ggajoch/SolderingStation/README.md

# Soldering station for Weller RT tips.
