ggajoch/SolderingStation/(list of files, cad)

Other CAD files:
3D/Hand.ipt
3D/case_bottom.ipt
3D/case_top.ipt
3D/stand.ipt
