ggajoch/SolderingStation/Hardware/Main/Show.PDF

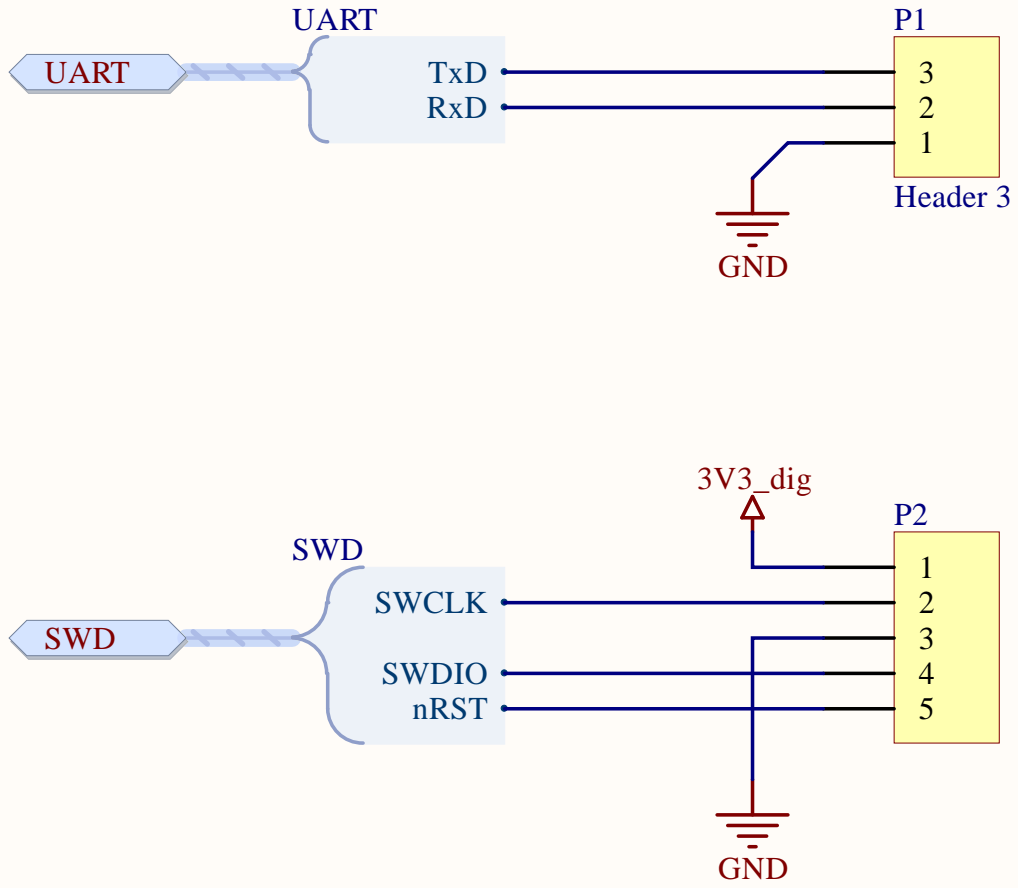
[picture p1: page 1]

Debug connectors Title | * Grzegorz Gajoch grzegorz@gajoch.pl

Size: A4 | Number: | Revision:
Date: 08-Oct-16 Time: 05:38:01 AM | | Sheet * of

E:\repos\WellerSolderingStation\Hardware\Main\DBG.SchDoc

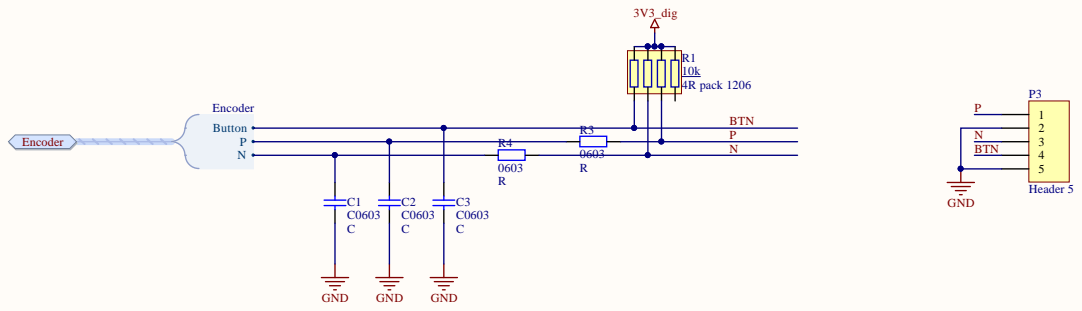
[picture p2: page 2]

Enco der connecto r T i t l e | *G rzeg o rz G aj och g rzeg o rz@g aj och.p l

Size: A | N umber: | Rev i s i o n :

8-Oct-1 T ime: : : A M | | Sheet o f

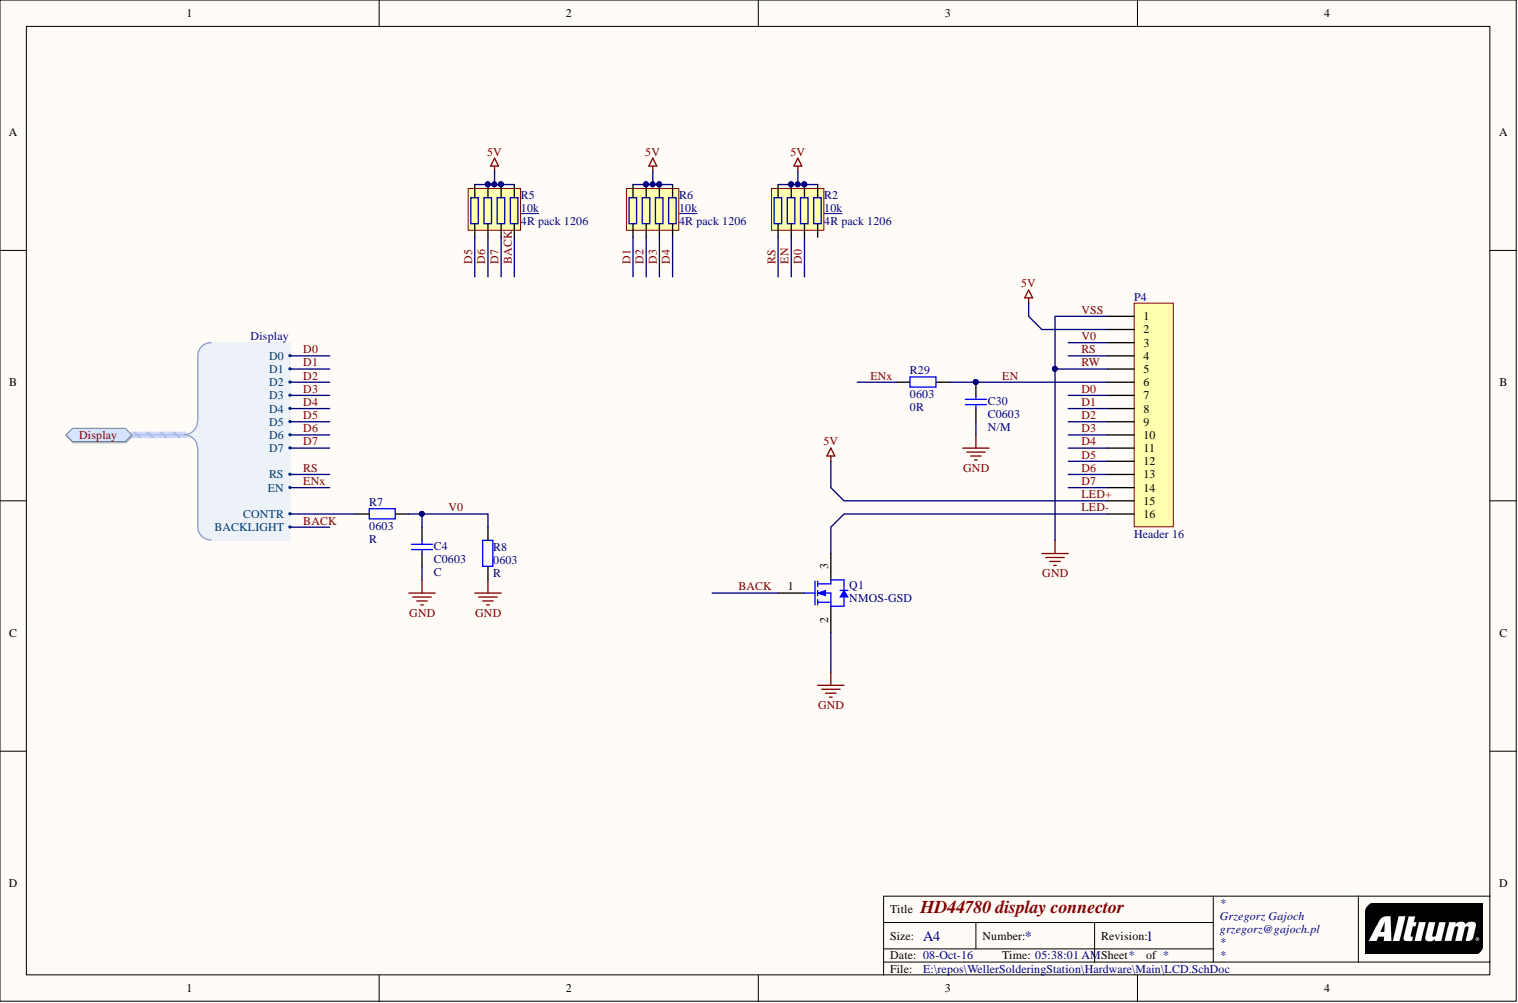
[picture p3: page 3]

HD 44 78 0 display connecto r T i t l e | *G rzeg o rz G aj och g rzeg o rz@g aj och.p l

Size: A | N umber: | Rev i s i o n :

8-Oct-1 T ime: : : A M | | Sheet o f

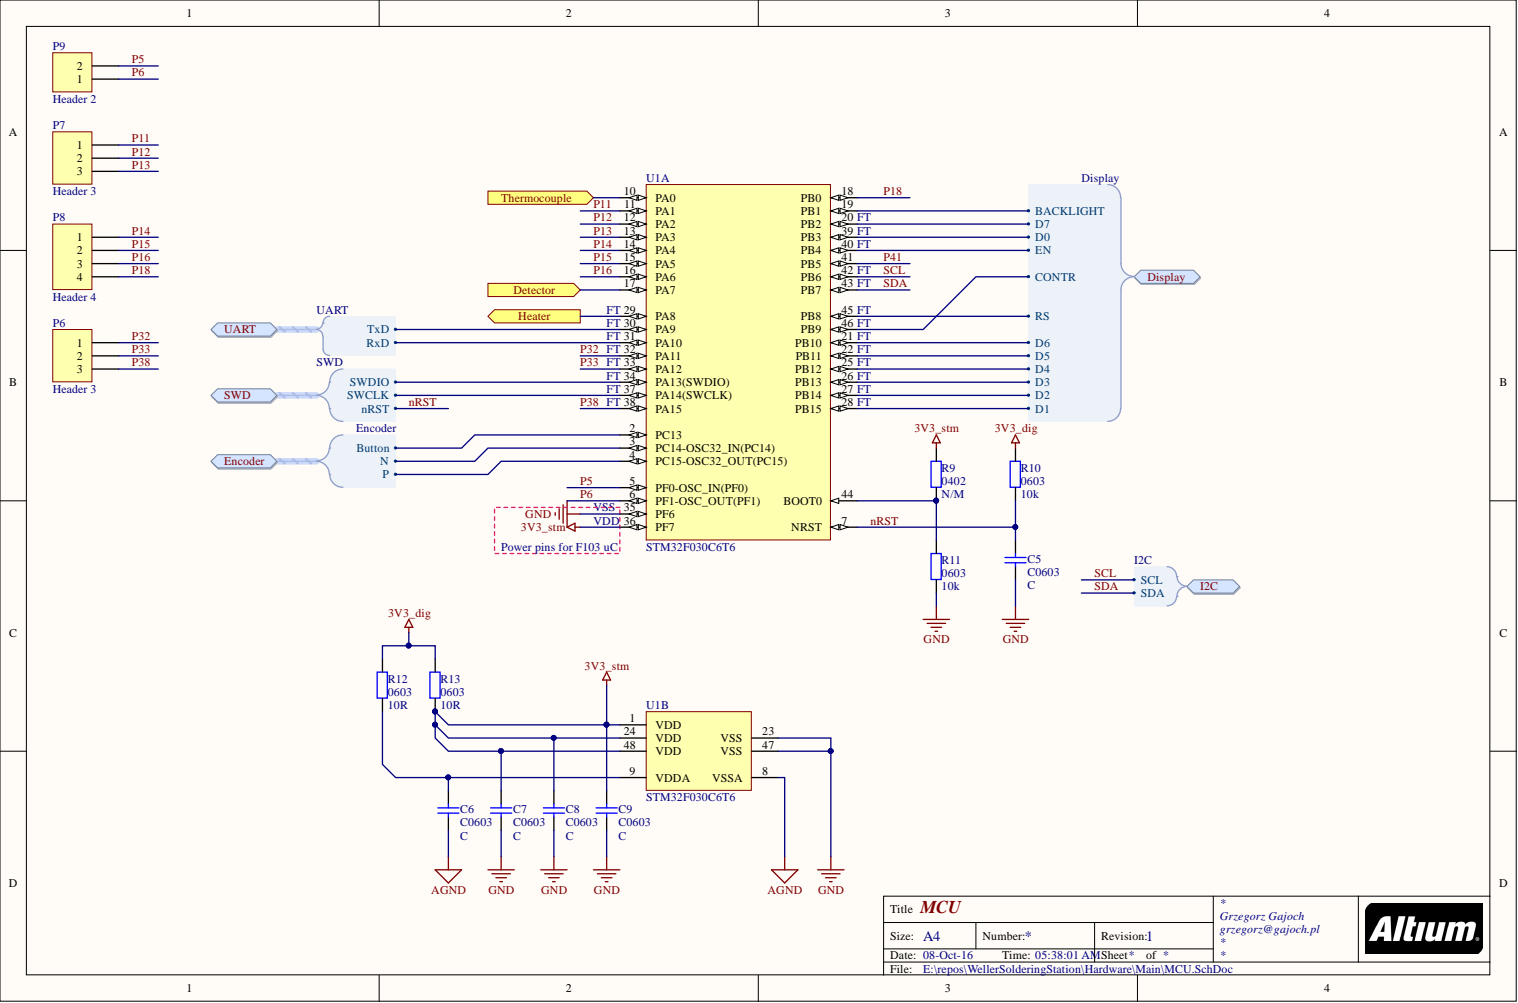
[picture p4: page 4]

PF6 35 | nRST
PF7 36

Power pins for F103 uC

MCU Title | * Grzegorz Gajoch grzegorz@gajoch.pl *

Size: A4 | Number: | Revision:
08-Oct-16 Time: 05:38:01 AM | | Sheet of *

E:\repos\WellerSolderingStation\Hardware\Main\MCU.SchDoc

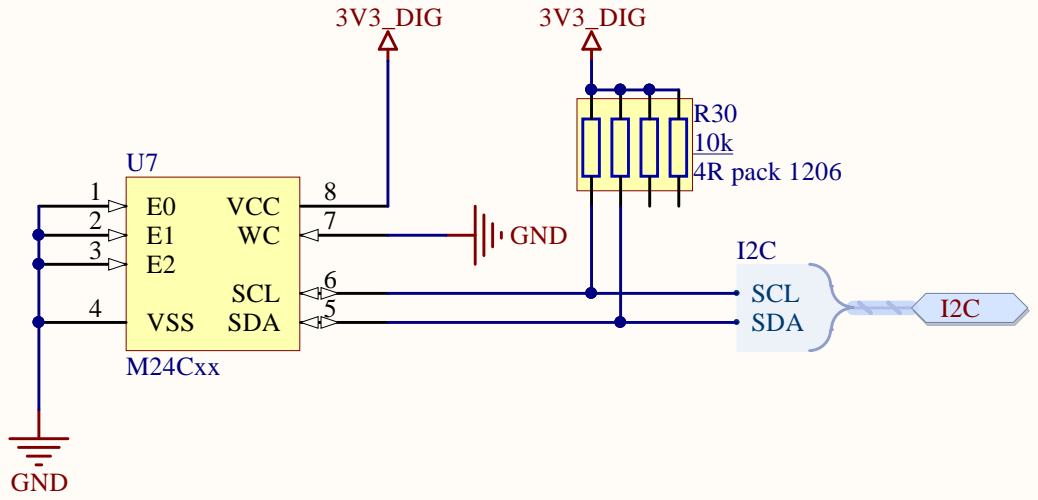
[picture p5: page 5]

I2C memory T i t l e | *G rzeg o rz G aj och g rzeg o rz@g aj och.p l

Size: A | N umber: | Rev i s i o n :

8-Oct-1 T ime: : : A M | | Sheet o f

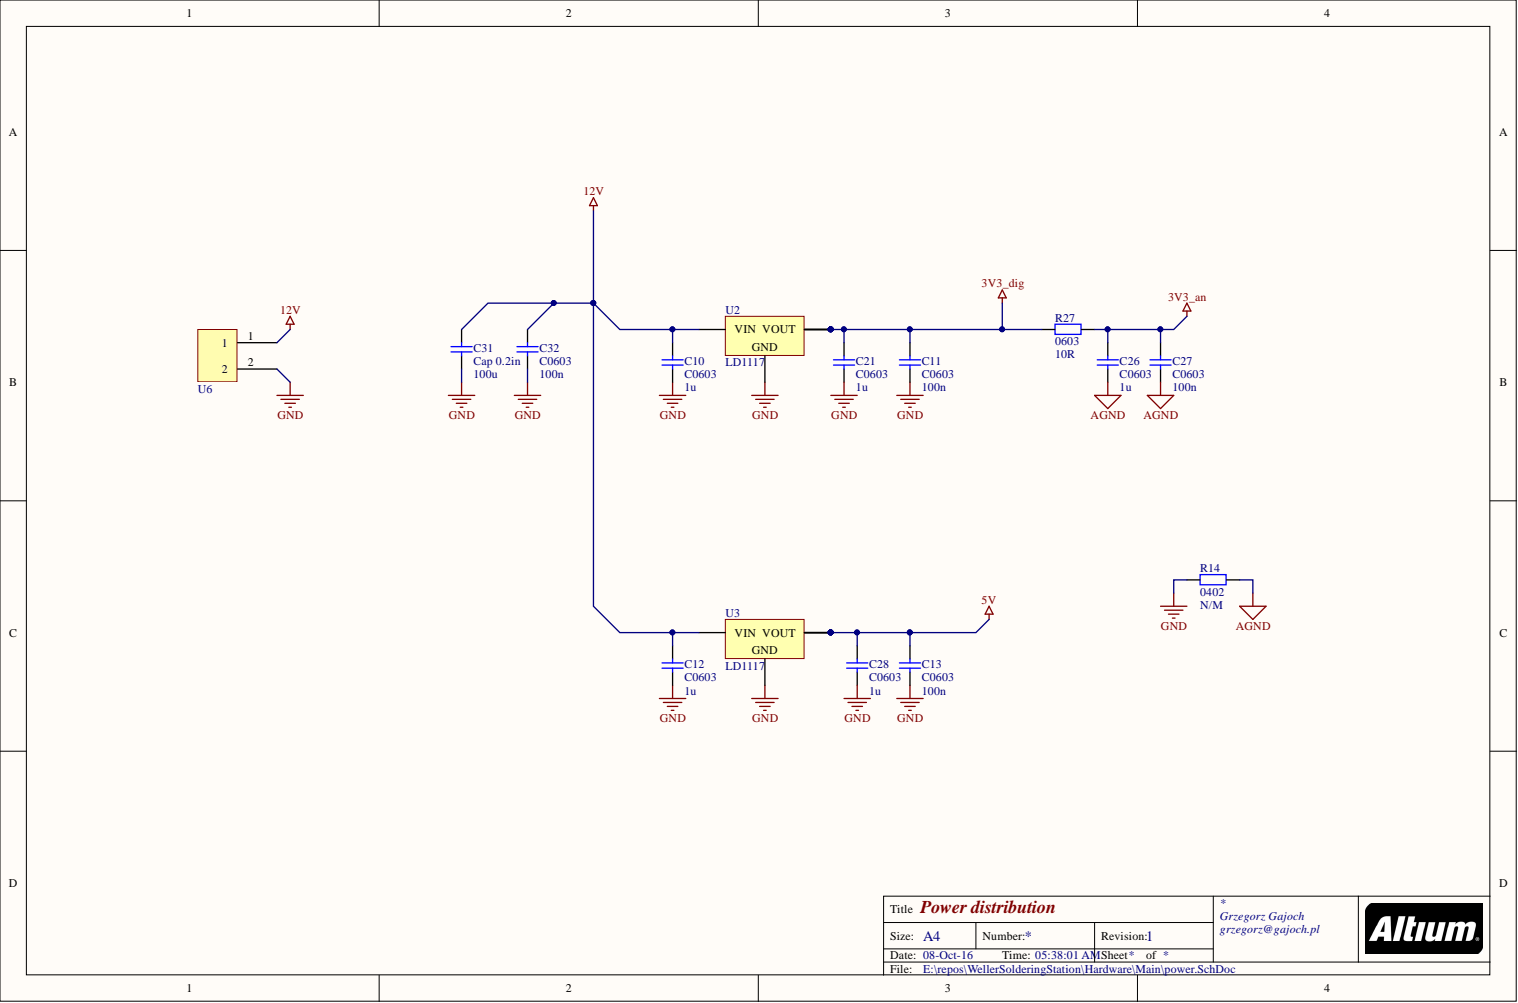
[picture p6: page 6]

Power distribution Title | * Grzegorz Gajoch grzegorz@gajoch.pl

Size: A4 | Number: | Revision:
08-Oct-16 Time: 05:38:01 AM | | Sheet of

E:\repos\WellerSolderingStation\Hardware\Main\power.SchDoc

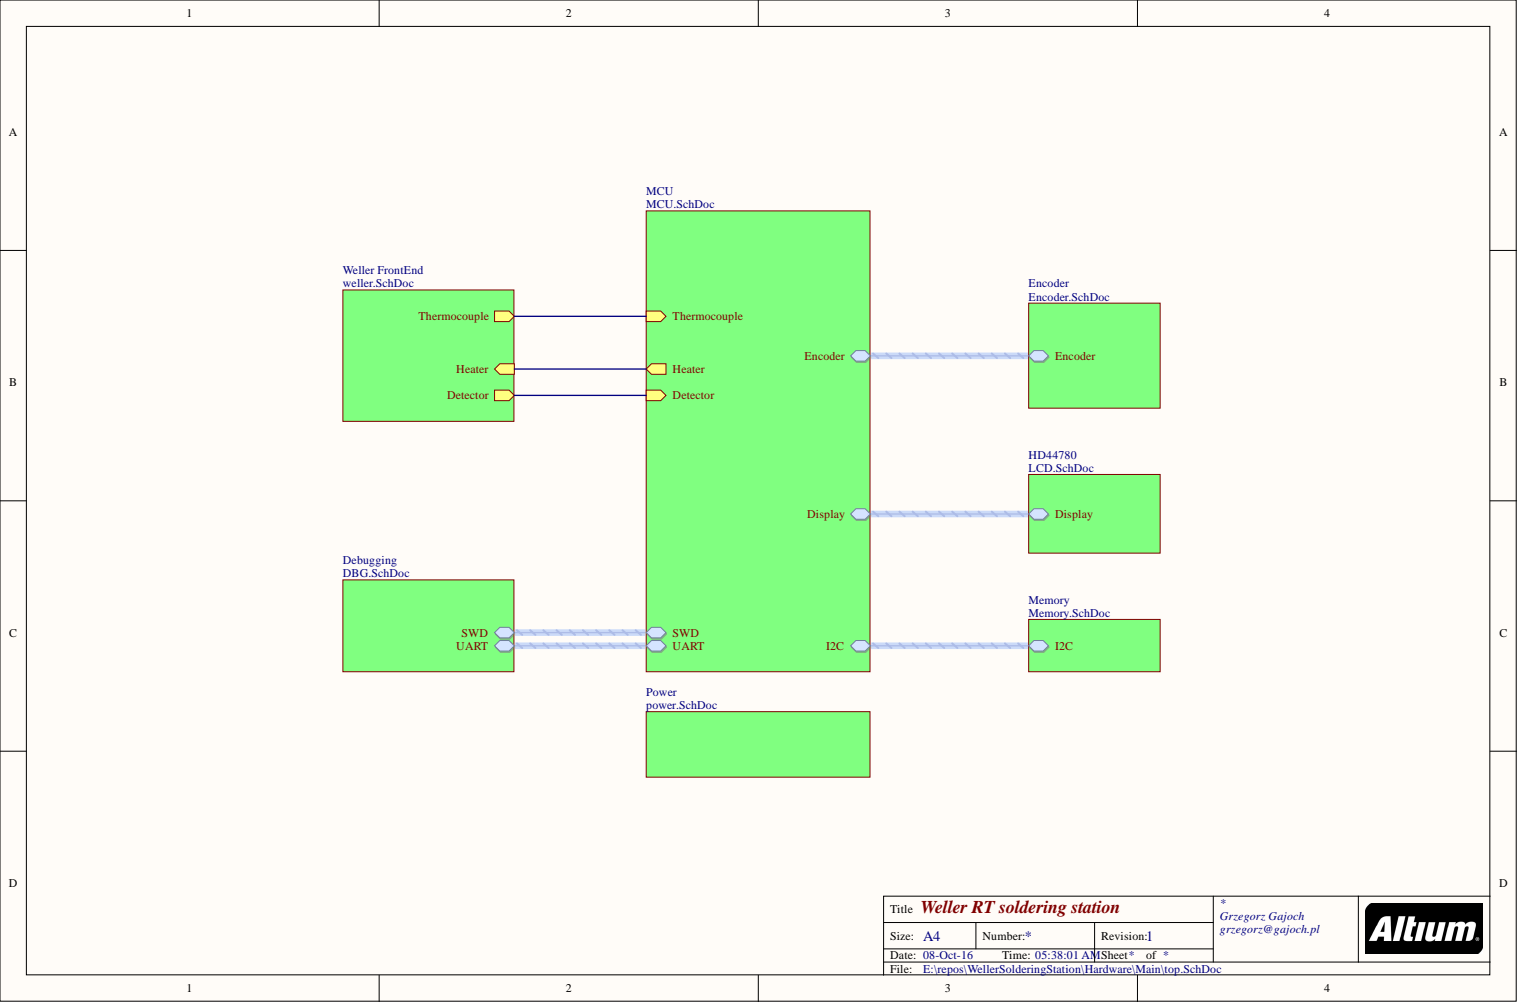
[picture p7: page 7]

Weller RT soldering station Title | * Grzegorz Gajoch grzegorz@gajoch.pl

Size: A4 | Number: | Revision:
08-Oct-16 Time: 05:38:01 AM | | Sheet of

E:\repos\WellerSolderingStation\Hardware\Main\top.SchDoc

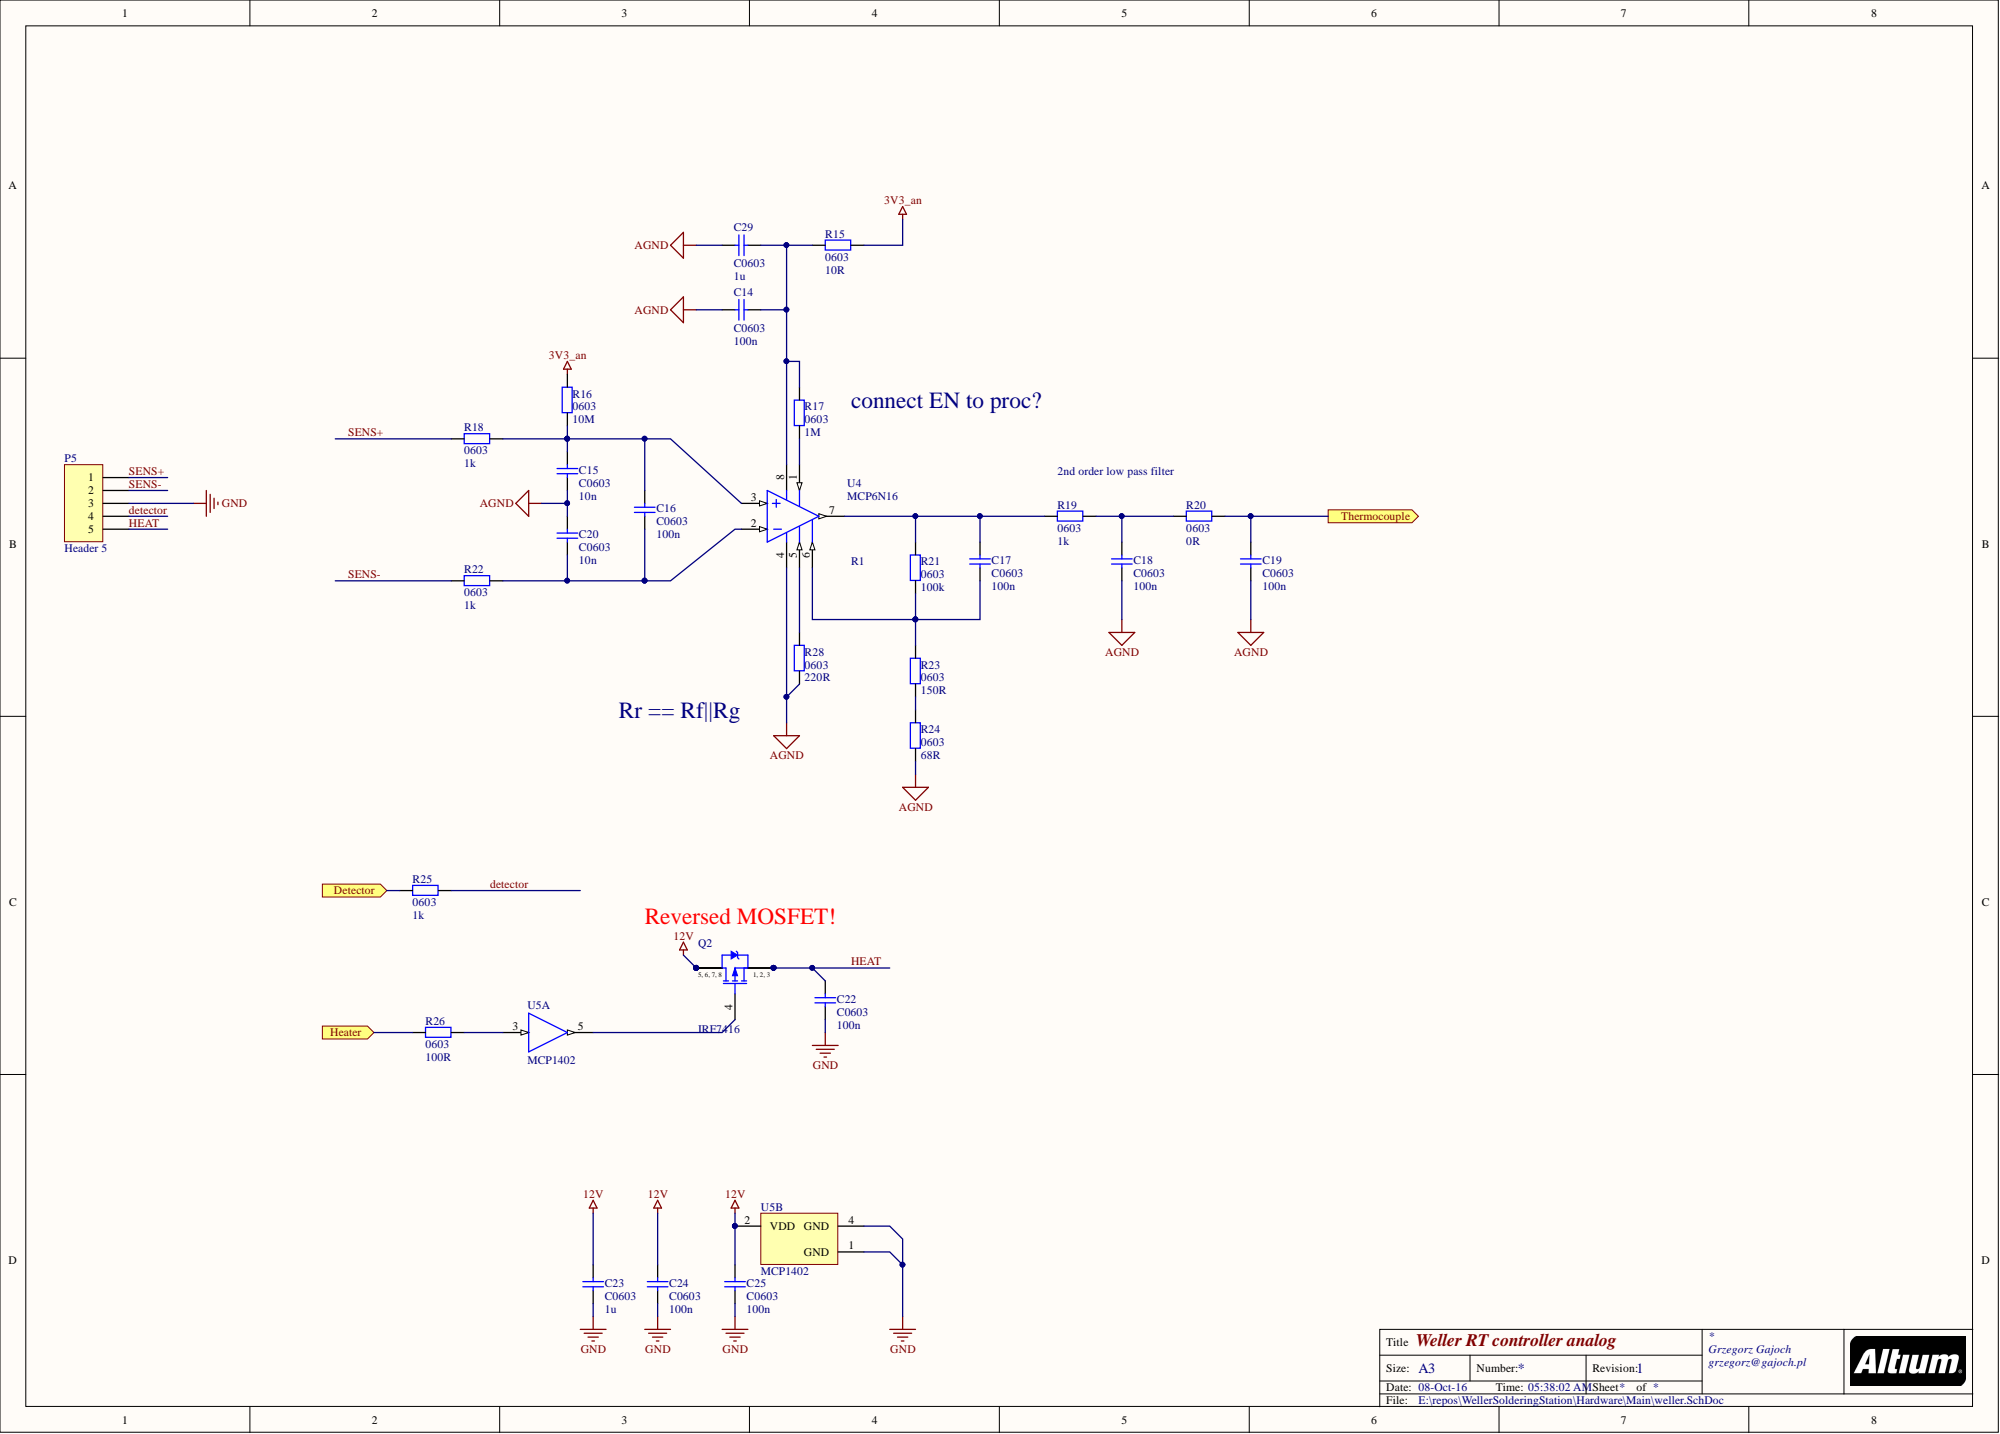
[picture p8: page 8]

connect EN to proc?

2nd order low pass filter

Weller RT controller analog Title | Grzegorz Gajoch grzegorz@gajoch.pl

Size: A3 | Number: | Revision:
08-Oct-16 Time: 05:38:02 AM | | Sheet of

E:\repos\WellerSolderingStation\Hardware\Main\weller.SchDoc

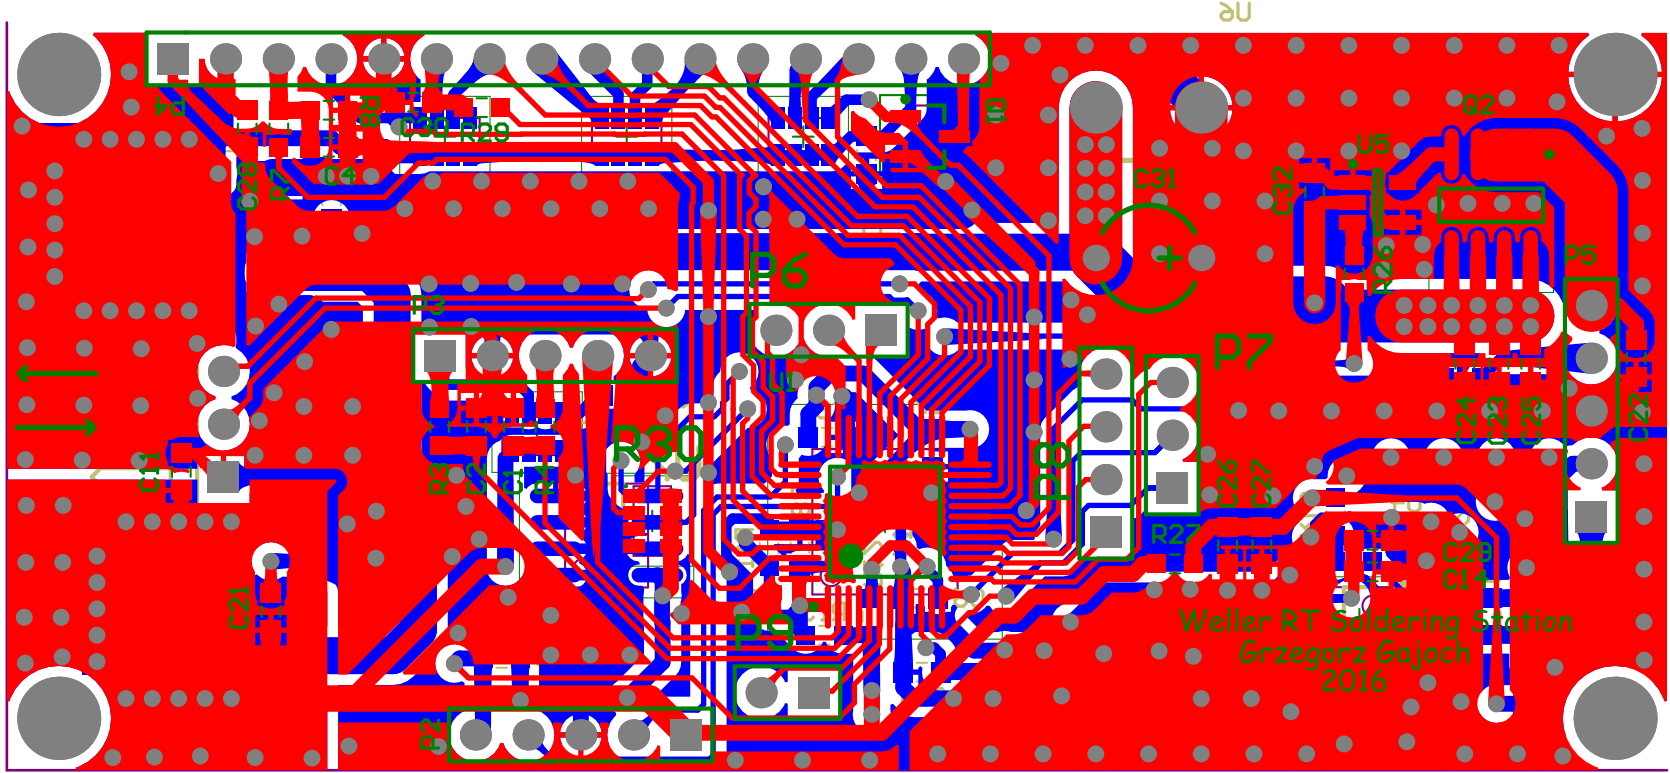
[picture p9: page 9]

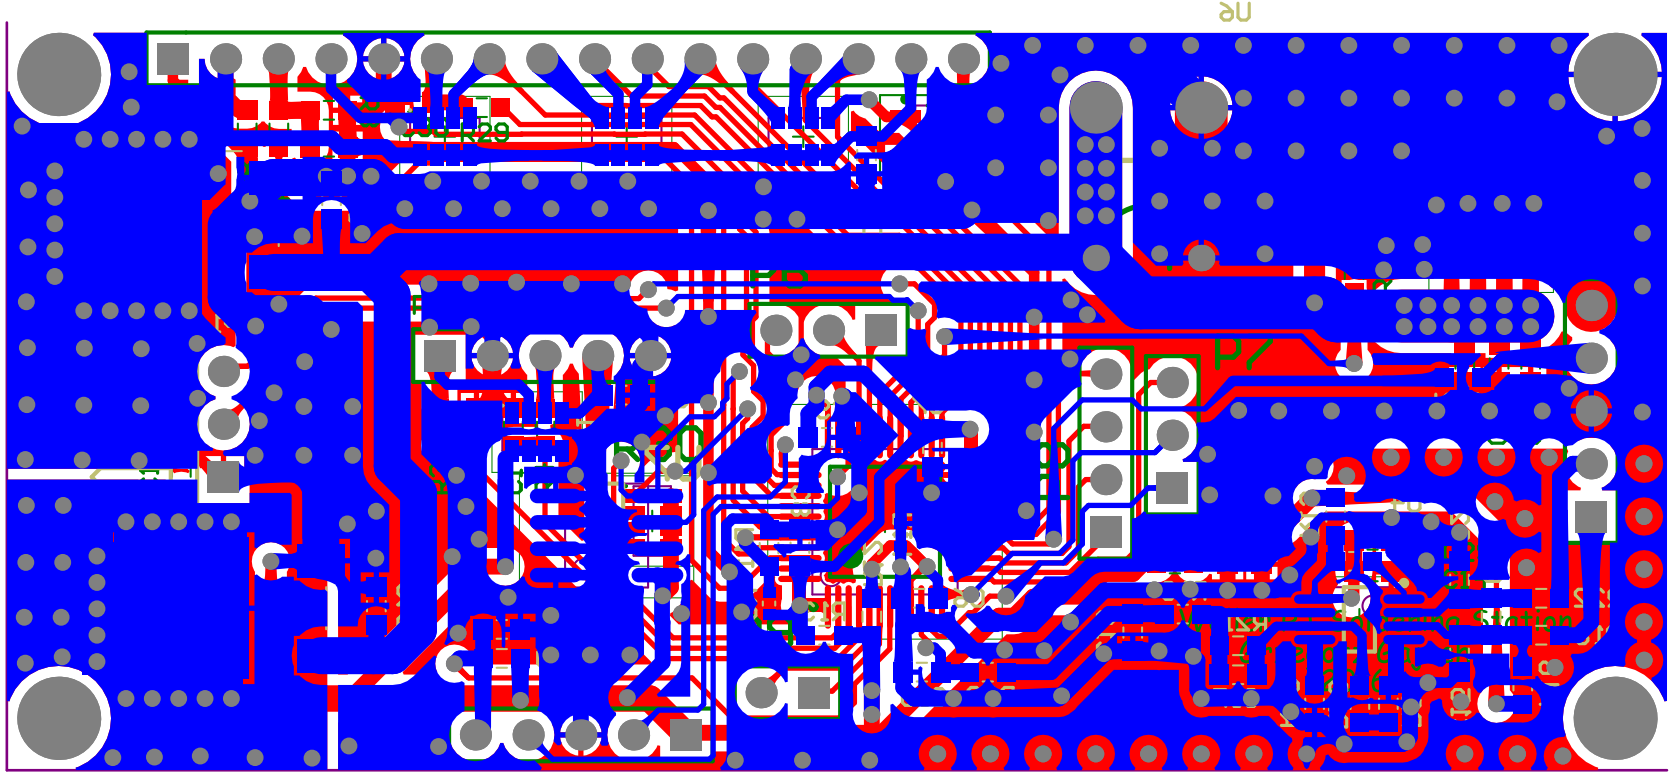
[picture p10: page 10]

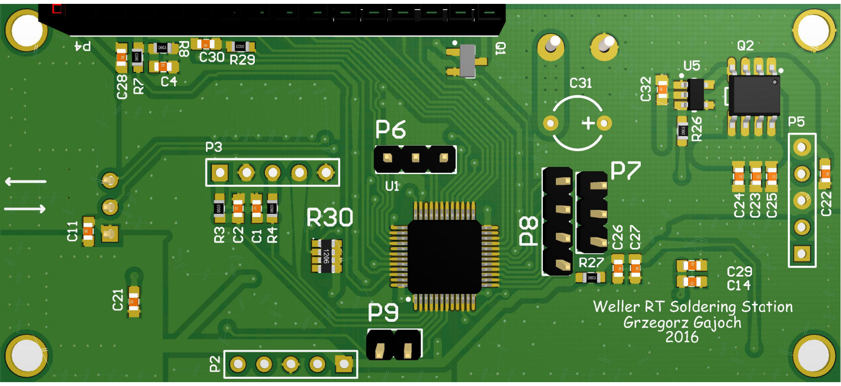
[picture p11: page 11]

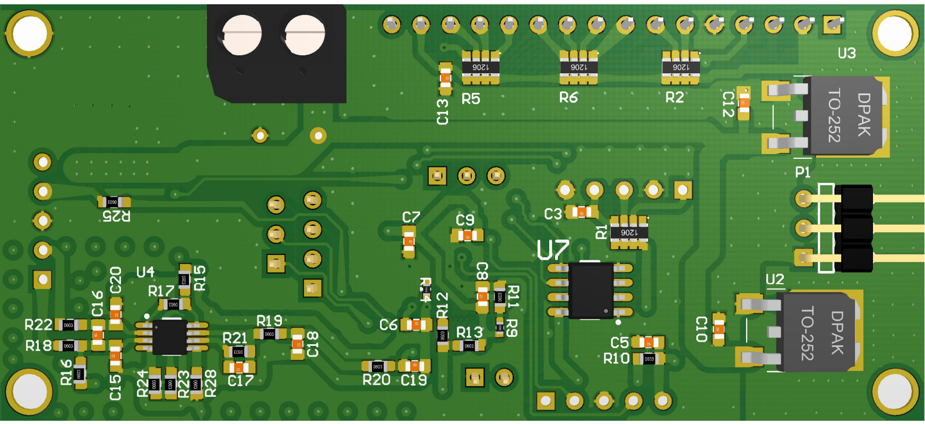
[picture p12: page 12]

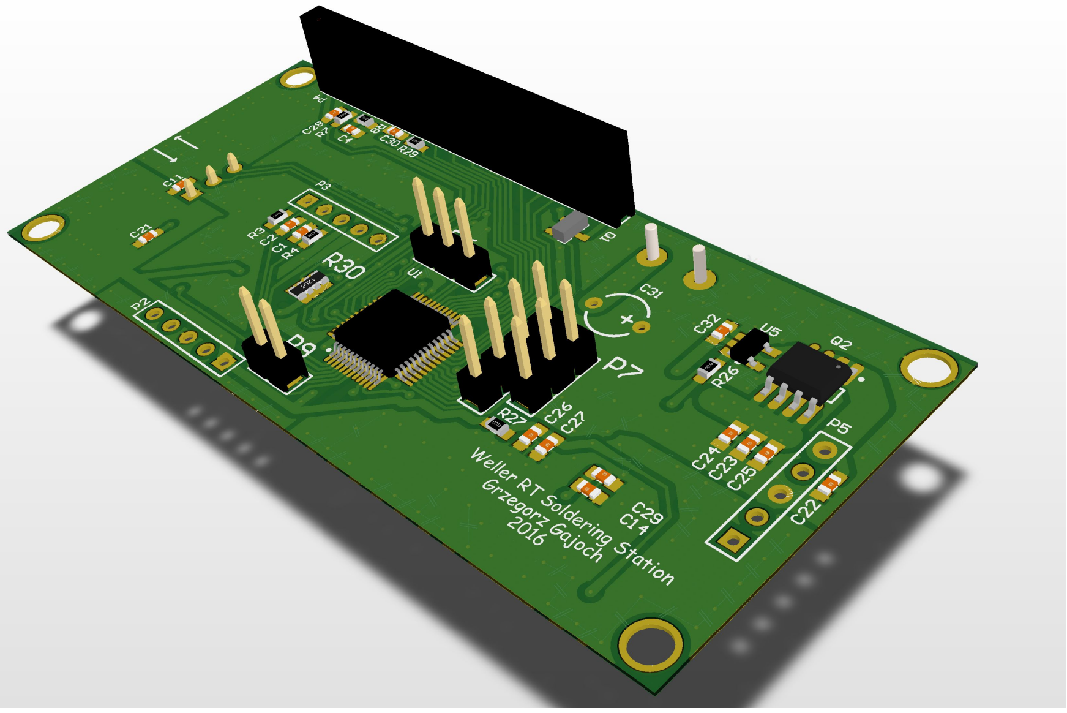
[picture p13: page 13]
