ggajoch/SolderingStation/(list of files, drawings)

Other design files:
Hardware/Main/DBG.SchDoc
Hardware/Main/Encoder.SchDoc
Hardware/Main/LCD.SchDoc
Hardware/Main/main.PcbDoc
Hardware/Main/main.PrjPcb
Hardware/Main/MCU.SchDoc
Hardware/Main/Memory.SchDoc
Hardware/Main/power.SchDoc
Hardware/Main/tipController.SchDoc
Hardware/Main/top.SchDoc
Hardware/MCP6N16/inst.PrjPcb
Hardware/MCP6N16/inst.SchDoc
Hardware/MCP6N16/OpAmp.SchDoc
Hardware/MCP6N16/PCB1.PcbDoc
Hardware/MCP6N16/top.SchDoc
Hardware/MCP1416/mini.PcbDoc
Hardware/MCP1416/Mini.PrjPcb
Hardware/MCP1416/opamp.PcbDoc
Hardware/MCP1416/top.SchDoc
