ggajoch/SolderingStation/Firmware/targets/arm/Inc/main.h

#define LCD_BACKLIGHT_CHANNEL 12
#define LCD_CONTRAST_CHANNEL 12
#define ENC_B_Pin GPIO_PIN_13
#define ENC_B_GPIO_Port GPIOC
#define ENC_N_Pin GPIO_PIN_14
#define ENC_N_GPIO_Port GPIOC
#define ENC_P_Pin GPIO_PIN_15
#define ENC_P_GPIO_Port GPIOC
#define ADC1_IN0_Pin GPIO_PIN_0
#define ADC1_IN0_GPIO_Port GPIOA
#define DETECTOR_Pin GPIO_PIN_7
#define DETECTOR_GPIO_Port GPIOA
#define LCD_BACKLIGHT_Pin GPIO_PIN_1
#define LCD_BACKLIGHT_GPIO_Port GPIOB
#define LCD_D7_Pin GPIO_PIN_2
#define LCD_D7_GPIO_Port GPIOB
#define LCD_D6_Pin GPIO_PIN_10
#define LCD_D6_GPIO_Port GPIOB
#define LCD_D5_Pin GPIO_PIN_11
#define LCD_D5_GPIO_Port GPIOB
#define LCD_D4_Pin GPIO_PIN_12
#define LCD_D4_GPIO_Port GPIOB
#define LCD_D3_Pin GPIO_PIN_13
#define LCD_D3_GPIO_Port GPIOB
#define LCD_D2_Pin GPIO_PIN_14
#define LCD_D2_GPIO_Port GPIOB
#define LCD_D1_Pin GPIO_PIN_15
#define LCD_D1_GPIO_Port GPIOB
#define USART1_TX_Pin GPIO_PIN_9
#define USART1_TX_GPIO_Port GPIOA
#define USART1_RX_Pin GPIO_PIN_10
#define USART1_RX_GPIO_Port GPIOA
#define LCD_D0_Pin GPIO_PIN_3
#define LCD_D0_GPIO_Port GPIOB
#define LCD_EN_Pin GPIO_PIN_4
#define LCD_EN_GPIO_Port GPIOB
#define LCD_RS_Pin GPIO_PIN_8
#define LCD_RS_GPIO_Port GPIOB
#define LCD_CONTRAST_Pin GPIO_PIN_9
#define LCD_CONTRAST_GPIO_Port GPIOB
