ggajoch/SolderingStation/Firmware/core/storage/state.cpp

#include "state.h"
#include "HAL.h"
#include "config.h"
#include "layout.h"

static_assert(sizeof(i2cMemorySettingsLayout) % 8 == 0, "Settings have to be 8-byte padded");
static_assert(sizeof(i2cMemoryStateLayout) == 4, "State needs to be 4-byte length");

constexpr static uint16_t max_slot() {
    constexpr uint16_t start_address = sizeof(i2cMemorySettingsLayout);
    constexpr auto size = static_cast<uint16_t>(core::config::memory_type);
    static_assert((size - start_address) % sizeof(i2cMemoryStateLayout) == 0, "");

    return (size - start_address) / sizeof(i2cMemoryStateLayout);
}

uint16_t slot_to_address(uint16_t slot) {
    uint16_t start_address = sizeof(i2cMemorySettingsLayout);

    return start_address + sizeof(i2cMemoryStateLayout) * slot;
}

i2cMemoryStateLayout stateLayout;

bool correct_marker(uint16_t slot) {
    HAL::Memory::get(slot_to_address(slot), gsl::span<uint8_t>(&stateLayout.marker, 1));
    return stateLayout.marker == 0x00;
}

bool get_slot(uint16_t slot) {
    HAL::Memory::get(slot_to_address(slot), stateLayout.as_span());
    return stateLayout.crc_match();
}

void erase_slot(uint16_t slot) {
    std::array<uint8_t, 1> marker{0xFF};
    HAL::Memory::set(slot_to_address(slot), marker);
}

void save_slot(uint16_t slot, i2cMemoryStateLayout data) {
    HAL::Memory::set(slot_to_address(slot), data.as_span());
}

bool find_state(uint16_t& slot, uint16_t& temperature) {
    bool found = false;
    for (uint16_t i = 0; i < max_slot(); ++i) {
        if (correct_marker(i)) {
            if (get_slot(i)) {
                slot = i;
                temperature = stateLayout.temperature;
                found = true;
                break;
            }
            erase_slot(i);
        }
    }

    for (uint16_t i = slot + 1; i < max_slot(); ++i) {
        if (correct_marker(i)) {
            erase_slot(i);
        }
    }

    return found;
}

std::optional<core::PersistentState> getState() {
    uint16_t slot = 0, temperature = 0;
    if (find_state(slot, temperature)) {
        return core::PersistentState{.target = temperature};
    }
    return {};
}

void saveState(core::PersistentState state) {
    uint16_t slot = 0, temperature = 0;
    if (find_state(slot, temperature)) {
        erase_slot(slot);
        slot++;
        if (slot >= max_slot()) {
            slot = 0;
        }
    }
    i2cMemoryStateLayout layout;
    layout.marker = 0x00;
    layout.temperature = state.target;
    layout.crc = layout.calculate_crc();
    save_slot(slot, layout);
}
