ggajoch/SolderingStation/Firmware/targets/arm/Inc/hd44780.h

#ifndef TARGETS_ARM_INC_HD44780_H_
#define TARGETS_ARM_INC_HD44780_H_

#ifdef __cplusplus
extern "C" {
#endif

#include <stdint.h>
#include "main.h"
#include "stm32f1xx_hal.h"

/**
 * @brief  Initializes HD44780 LCD
 * @brief  cols: width of lcd
 * @param  rows: height of lcd
 * @retval None
 */
void TM_HD44780_Init(uint8_t cols, uint8_t rows);

/**
 * @brief  Turn display on
 * @param  None
 * @retval None
 */
void TM_HD44780_DisplayOn(void);

/**
 * @brief  Turn display off
 * @param  None
 * @retval None
 */
void TM_HD44780_DisplayOff(void);

/**
 * @brief  Clears entire LCD
 * @param  None
 * @retval None
 */
void TM_HD44780_Clear(void);

/**
 * @brief  Puts string on lcd
 * @param  x location
 * @param  y location
 * @param  *str: pointer to string to display
 * @retval None
 */
void TM_HD44780_Puts(uint8_t x, uint8_t y, const char* str);

/**
 * @brief  Enables cursor blink
 * @param  None
 * @retval None
 */
void TM_HD44780_BlinkOn(void);

/**
 * @brief  Disables cursor blink
 * @param  None
 * @retval None
 */
void TM_HD44780_BlinkOff(void);

/**
 * @brief  Shows cursor
 * @param  None
 * @retval None
 */
void TM_HD44780_CursorOn(void);

/**
 * @brief  Hides cursor
 * @param  None
 * @retval None
 */
void TM_HD44780_CursorOff(void);

/**
 * @brief  Scrolls display to the left
 * @param  None
 * @retval None
 */
void TM_HD44780_ScrollLeft(void);

/**
 * @brief  Scrolls display to the right
 * @param  None
 * @retval None
 */
void TM_HD44780_ScrollRight(void);

/**
 * @brief  Creates custom character
 * @param  location: Location where to save character on LCD. LCD supports up to 8 custom characters, so locations are 0 - 7
 * @param *data: Pointer to 8-bytes of data for one character
 * @retval None
 */
void TM_HD44780_CreateChar(uint8_t location, uint8_t* data);

/**
 * @brief  Puts custom created character on LCD
 * @param  location: Location on LCD where character is stored, 0 - 7
 * @retval None
 */
void TM_HD44780_PutCustom(uint8_t x, uint8_t y, uint8_t location);

#ifdef __cplusplus
}
#endif

#endif  // TARGETS_ARM_INC_HD44780_H_
