ggajoch/SolderingStation/Firmware/targets/x86/simulation/HALsim.h

#pragma once

#include "HAL.h"
#include <queue>

namespace HAL {

namespace Tip {
    extern float heatingPercentage;
    extern bool inStandFlag;
}  // namespace Tip

namespace Encoder {
    extern int count;
}  // namespace Encoder

}  // namespace HAL
