ggajoch/SolderingStation/(commit log)

2015-12-27 firmware for olimex board
2015-12-27 hand && stand v0.1
    [Hand.ipt, stand.ipt]
2015-12-28 moved to my libraries
    [DGB.SchDoc, Encoder.SchDoc, LCD.SchDoc, MCU.SchDoc, power.SchDoc, weller.SchDoc]
2015-12-31 firmware updated to use MCP1402 - inverting power
    [main.cpp]
2015-12-31 during placement of components
    [DBG.SchDoc, Encoder.SchDoc, LCD.SchDoc, MCU.SchDoc, main.PcbDoc, main.PrjPcb, power.SchDoc, top.SchDoc]
2016-01-08 FT markings, compatibility with F103
    [MCU.SchDoc]
2016-01-08 3V3 bad name
    [power.SchDoc]
2016-01-08 during component placing
    [main.PcbDoc]
2016-02-20 Main board first version
    [DBG.SchDoc, LCD.SchDoc, MCU.SchDoc, main.PrjPcb, power.SchDoc, weller.SchDoc]
2016-02-22 Main board routing, memory added
    [Memory.SchDoc, main.PrjPcb]
2016-02-22 Memory routed
    [MCU.SchDoc, Memory.SchDoc, main.PrjPcb, top.SchDoc]
2016-03-26 Project template for new board, based on cubemx.
    [Olimex-STM32-P103.cfg]
2016-03-27 newlib, printf()
2016-03-27 HAL using uart interrupt, CLI example
2016-03-27 UART IRQ TX
2016-03-27 much more clean implemenetation of HD44780 driver with example
2016-03-27 LCD on timer interrupt
2016-03-27 ADC implementation
2016-03-27 heating timer
2016-03-28 enabling TIM2, HardFault on printf() inside interrupt repaired
2016-03-28 displaying adc on timer tick
2016-03-28 encoder implementation
2016-03-28 encoder refactor
2016-03-29 p-mos with non-inverting buffer - heating default to off
2016-03-29 commands to setting temperature and pid coefficients
2016-03-29 inverted heater logic
2016-03-29 PID and basic soldering station tick implementation
2016-10-06 removed old files
    [DGB.SchDoc, general OpAmp.SchDoc, main.PrjPcb, mosfet.SchDoc]
2016-10-07 schematic nicer drawings
    [DBG.SchDoc, Encoder.SchDoc, LCD.SchDoc, MCU.SchDoc, Memory.SchDoc, power.SchDoc, top.SchDoc, weller.SchDoc]
2016-10-08 PDF for main board
    [main.PrjPcb]
2016-10-23 PID controller (with back-calculation anti-windup) with basic tests
2016-10-24 PID, simple plant model of soldering tip
2016-10-24 reversed PID control, plant model and PID tests
    [PID.cpp, PIDforTip.cpp, plantModel.cpp, plantModel.h]
2016-10-25 PID anti-windup refactor
2016-10-26 two commands - temperature & PID values
2016-10-26 controller tick print
2016-10-29 simulation in LV - drivers and basic data handling
2016-10-31 encoder simulation
2016-10-31 timer & storage
2016-11-01 schematic rename
    [main.PrjPcb, tipController.SchDoc, top.SchDoc, weller.SchDoc]
2016-11-01 PCB as manufactured.
    [main.PrjPcb]
2016-11-06 STM32F103 cube drivers
2016-11-06 pid stabilize in mid-degree
2016-11-06 STM32F103 project in HAL CubeMX SW4STM32
2016-11-06 corrected values on schematic
    [LCD.SchDoc, MCU.SchDoc, power.SchDoc, tipController.SchDoc]
2016-11-24 Values of components updated in PcbDoc
2016-11-25 resistors for encoder and mcu model corrected
    [Encoder.SchDoc, MCU.SchDoc]
2016-11-26 Corrected C17 in feedback loop to Not Mount
    [tipController.SchDoc]
2016-11-27 updated backlight transistor model
    [LCD.SchDoc]
2016-11-30 test fixes
    [CPPLINT.cfg]
2016-12-18 corrected cast error - building again
    [HAL.cpp]
2016-12-20 Added drivers for: Encoder (GPIO + TIM2@10kHz) and EEPROM I2C - compiling & working
    [SolderingStation.cfg]
2016-12-22 files for encoder drivers
2016-12-22 Encoder basically working
2016-12-24 ARM target
2016-12-27 Disabled all warnings for all Driver files
2016-12-27 encoder button working
2016-12-28 no callback in encoder IRQ
2016-12-28 remove cfg file
    [SolderingStation.cfg]
2016-12-31 IWDG working @ 2.44Hz
2016-12-31 initial files for memory driver
2017-01-02 stub of memory driver - returning const settings
2017-01-03 i2c memory driver now returns also State
2017-01-03 function for handling i2c memory writing
2017-01-18 memory temperature writing & indicator
2017-01-19 disable heating when EEPROM R/W to prevent overheating
    [i2c_memory.cpp]
2017-01-21 corrected behavior of lineDebounce
    [LineDebounce.cpp]
2017-01-21 LineDebounce corrected for critical conditions
    [LineDebounce.cpp]
2017-01-21 corrected test when value can be undefined
    [LineDebounce.cpp]
2017-01-23 corrected heap & stack size as cause of hard fault
    [SolderingStation.ioc]
2017-11-11 Fix unit test compilation
    [Commands.cpp, HALsim.cpp]
2017-11-12 encoder button handler, not callback
2017-11-12 Fix printf in temp target
2017-11-14 Socket based communication based on Boost ASIO
2017-11-14 First basic version based on PyQt, PyQtGraph and socket to simulator
2017-11-14 Point plotted using correct threading
2017-11-14 Three curves - actual, setpoint and power
2017-11-17 configuration of the device
2017-11-18 Fix arm build
2017-11-19 Workaround for GSL span issue (in unit tests)
    [CLI.cpp]
2018-01-10 Fix x86 compilation errors
    [HALsim.cpp, main.cpp]
2018-01-10 Max power limit added to configuration
2018-01-26 Fix timer glitches during pwm start
    [HAL.cpp, MY_main.cpp, SolderingStation.ioc]
2018-01-26 Max power sent during config dump
2018-01-26 Second line bar reflects max power
2018-02-07 Add separate configurable sleep and stand temperatures.
2018-02-17 Fix casting device string to PySerial
2018-02-17 Added OFF mode - activated by holding encoder button. In this mode heater is always disabled.
2018-02-20 Fix removal of gsl::span.length method
    [HALmock.cpp, HALsim.cpp]
2018-02-20 Enable arm travis build
2018-02-24 Added max temperature setting
2020-08-03 3D model of case
    [case_bottom.ipt, case_top.ipt]
2020-08-12 Fix compilation errors on gcc 10.2
    [base.h]
2021-03-22 reset PID when overtemp instead of shutting down the device
2026-01-25 Fix reversed mosfet
2026-01-26 Add GND header
