ggajoch/SolderingStation/(notices)

Notices in the files:
Firmware/targets/arm/Inc/main.h:
COPYRIGHT(c) 2018 STMicroelectronics
(C) COPYRIGHT STMicroelectronics *****END OF FILE
